ArturR0k3r/AkiraE/0. HW/Akira Basic/Screenshot 2024-01-05 033526.png

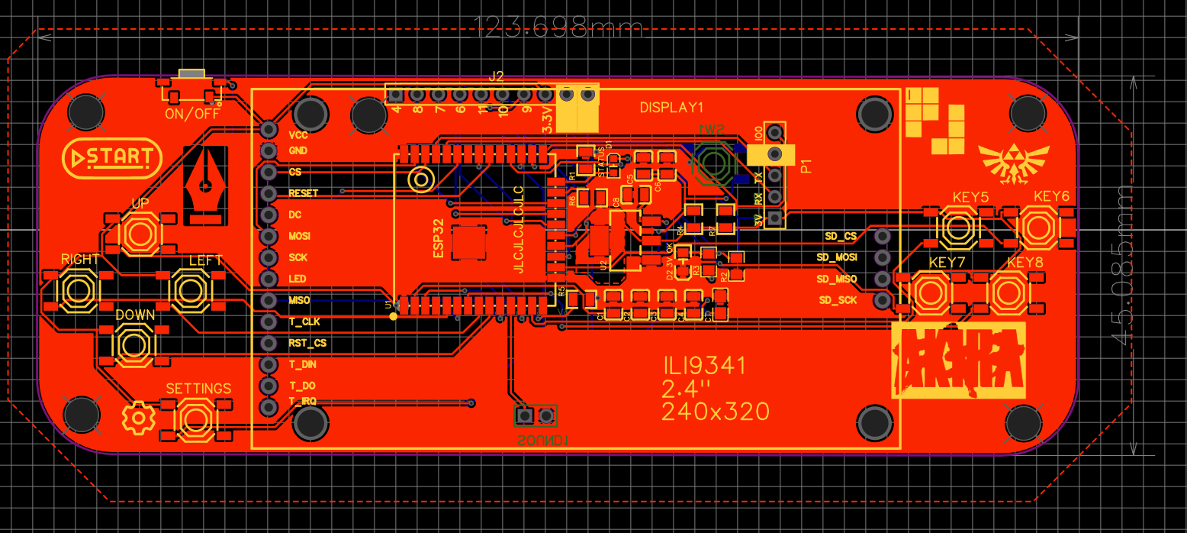
0. HW/Akira Basic/Screenshot 2024-01-05 033526.png
