ArturR0k3r/AkiraE/0. HW/Akira f1/Screenshot 2024-01-05 034120.png

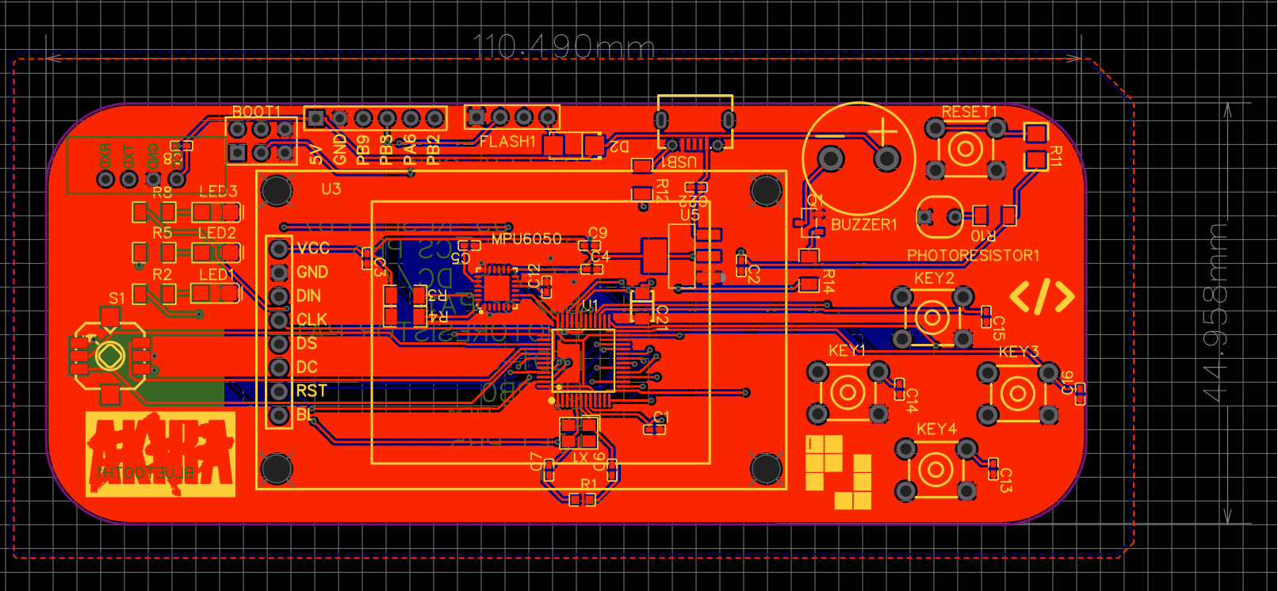
0. HW/Akira f1/Screenshot 2024-01-05 034120.png
