ArturR0k3r/AkiraE/0. HW/Akira Joystick/Screenshot 2024-01-05 034321.png

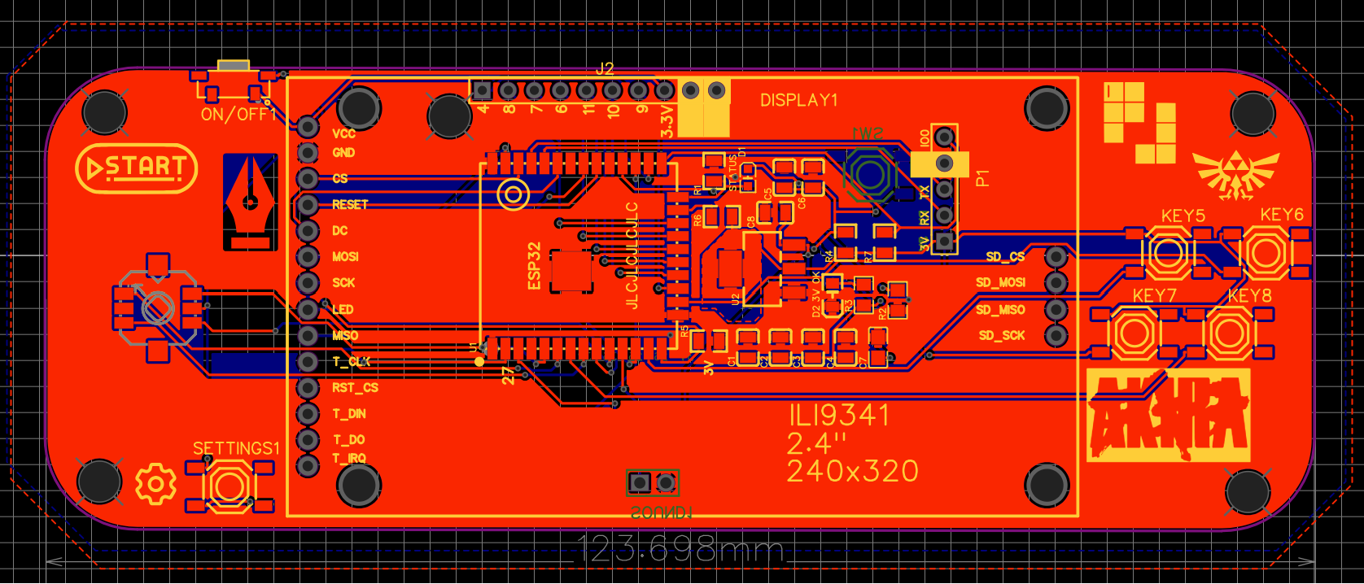
0. HW/Akira Joystick/Screenshot 2024-01-05 034321.png
