ArturR0k3r/AkiraE/2. Design and 3D Models/AkiraE-2024-01-15 162406.png

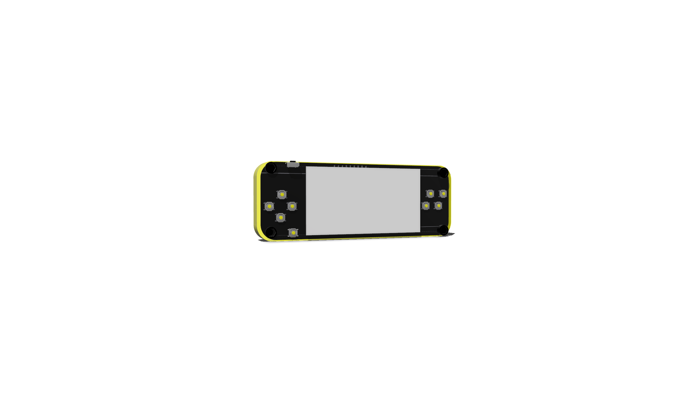
2. Design and 3D Models/AkiraE-2024-01-15 162406.png
