ArturR0k3r/AkiraE/2. Design and 3D Models/Drawings/image (8).png

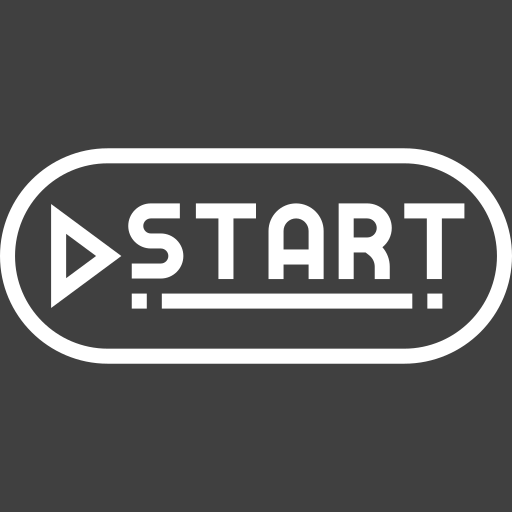
2. Design and 3D Models/Drawings/image (8).png
