ArturR0k3r/AkiraE/2. Design and 3D Models/Drawings/settings (1).png

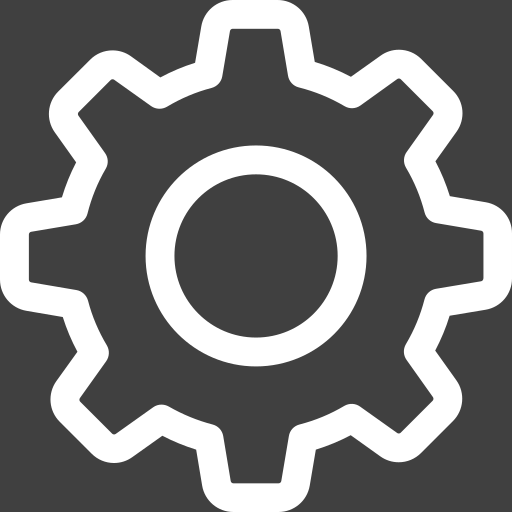
2. Design and 3D Models/Drawings/settings (1).png
