ArturR0k3r/AkiraE/2. Design and 3D Models/Drawings/video-game.png

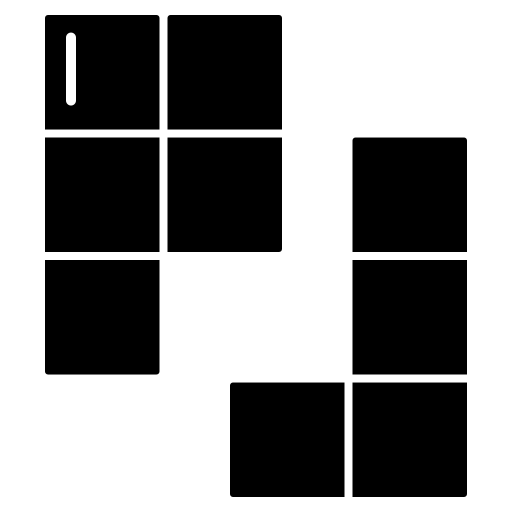
2. Design and 3D Models/Drawings/video-game.png
