ArturR0k3r/AkiraE/2. Design and 3D Models/Screenshot 2024-01-15 163319.png

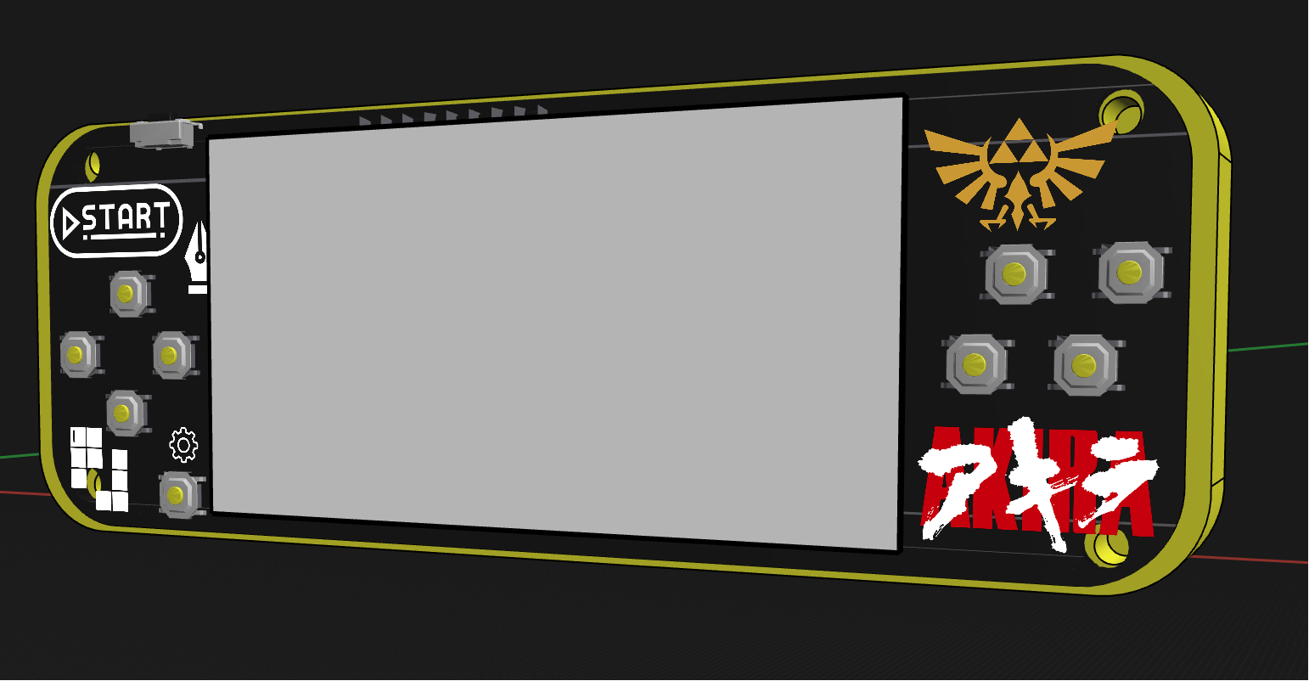
2. Design and 3D Models/Screenshot 2024-01-15 163319.png
