ArturR0k3r/AkiraE/2. Design and 3D Models/Screenshot_2024-01-15_163319-removebg-preview.png

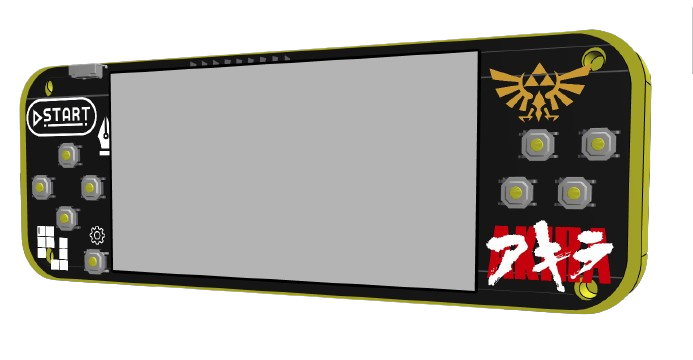
2. Design and 3D Models/Screenshot_2024-01-15_163319-removebg-preview.png
