ArturR0k3r/AkiraE/0. HW/Akira Basic/BOM_PCB_Akira_Basic_2024-01-05.csv

ID | Name | Designator | Footprint | Quantity | Manufacturer Part | Manufacturer | Supplier | Supplier Part | Price
1 | HDR-M-2.54_1x2 | SOUND1 | HDR-M-2.54_1X2 | 1 |  |  | LCSC | C124375 | 0.022
2 | RESET | SW1 | SW-SMD_4P-L5.1-W5.1-P3.70-LS6.5-TL-2 | 1 | TS-1187A-B-A-B | XKB Enterprise | LCSC | C318884 | 0.016
3 | HDR-M-2.54_1x10 | J2 | HDR-M-2.54_1X10 | 1 |  |  | LCSC | C57369 | 0.044
4 | 100nF | C4,C6,C8 | C0805 | 3 | CC0805KRX7R9BB104 | YAGEO | LCSC | C49678 | 0.005
5 | AMS1117-3.3 | U2 | SOT-223-3_L6.5-W3.4-P2.30-LS7.0-BR | 1 | AMS1117-3.3 | AMS | LCSC | C6186 | 0.141
6 | ESP32 | U1 | WIFIM-SMD_38P-L19.2-W18.0-P1.27 | 1 | ESP32 |  | LCSC | C328062 | 3.338
7 | 470Ω | R3,R2 | R0805 | 2 | 0805W8F4700T5E | UniOhm | LCSC | C17710 | 0.002
8 | 10K | R7,R6,R5,R4,R1 | R0805 | 5 | 0805W8F1002T5E | UniOhm | LCSC | C17414 | 0.001
9 | YELLOW | D2 | LED0805-RD | 1 | 17-21SUYC/TR8 | KENTO | LCSC | C2296 | 0.012
10 | 1uF | C5 | C0805 | 1 | CL21B105KBFNNNE | SAMSUNG | LCSC | C28323 | 0.009
11 | 10uF | C1,C2,C3,C7 | C0805 | 4 | CL21A106KAYNNNE | SAMSUNG | LCSC | C15850 | 0.011
12 | Header-Male-2.54_1x5 | P1 | HDR-5X1/2.54 | 1 | Header-Male-2.54_1x5 | LCSC
13 | STATUS (BLUE) | D1 | LED0603-R-RD | 1 | 19-217/BHC-ZL1M2RY/3T | EVERLIGHT | LCSC | C72041 | 0.018
14 | 2.4_TFT_ILI9341_symbol | DISPLAY1 | ILI9341_320X240_TFT_LCD | 1 |  |  | Nettigo | ili9341-24-touch
15 | BUTTON_C9900016052 | KEY5,KEY7,KEY8,KEY6,UP,SETTINGS,RIGHT,LEFT,DOWN | SW-SMD_4P-L5.1-W5.1-P3.70-LS6.5-TL-2 | 9 | button | null | LCSC | C9900016052
16 | TL3330AF260QG | ON/OFF | SW-SMD_E-SWITCH_TL3330 | 1 | TL3330AF260QG | E-Switch | LCSC | C2886886 | 0.358
