ArturR0k3r/AkiraE/0. HW/Akira f1/BOM_PCB_Akira_f1_2024-01-05.csv

ID | Name | Designator | Footprint | Quantity | Manufacturer Part | Manufacturer | Supplier | Supplier Part | Price
1 | HC06 | BLUETOOTH1 | HC06 | 1 |  |  | LCSC
2 | 10uF | C8 | C0402 | 1 | VT1H0R1MB054000CE0 | Changzhou Huawei Elec | LCSC | C271438 | 0.035
3 | 22uF | C9 | C0402 | 1 | VT1H0R1MB054000CE0 | Changzhou Huawei Elec | LCSC | C271438 | 0.035
4 | Photoresistor-5528 | PHOTORESISTOR1 | SNR2-3.0 | 1 | Photoresistor-5528
5 | Headers Pins 1*4P | FLASH1 | HDR-4X1/2.54 | 1 | Headers Pins 1*4P | ReliaPro | LCSC
6 | BUZZER | BUZZER1 | BUZ-TH_BD12.0-P6.00-D0.9-RD | 1 | buzzer | null | LCSC | C9900014030
7 | 100nF | C1,C2,C3,C4,C12,C13,C14,C15,C16,C21,C22 | C0402 | 11 | TAJA104K035RNJ | Kyocera AVX | LCSC | C7173 | 0.162
8 | XTAL4-3.2X2.5 8MHz | X1 | CRYSTAL-SMD_4P-L3.2-W2.5-BL | 1 | XTAL4-3.2X2.5 | null | LCSC | C9900003449
9 | USB-111FD-B-SU | USB1 | USB-SMD_USB-111FD-B-SU | 1 | USB-111FD-B-SU B型 | HOOYA(香港皓宇) | LCSC | C2939564 | 0.099
10 | LM1117MPX-25NOPB | U5 | SOT-223_L6.5-W3.5-P2.30-LS7.0-BR | 1 | LM1117MPX-25NOPB | onsemi(安森美) | LCSC | C2902257 | 0.584
11 | 1.8inch LCD TFT ST7735S Waveshare | U3 | 1.8 LCD TFT ST7735S WAVESHARE | 1
12 | STM32F103C8T6 | U1 | LQFP-48_L7.0-W7.0-P0.50-LS9.0-BL | 1 | STM32F103C8T6 | ST(意法半导体) | LCSC | C8734 | 1.421
13 | JOYSTICK_MINI | S1 | JOYSTICK_MINI | 1
14 | 10k | R11 | 1206 | 1 | ?
15 | 470Ω | R14 | R1206 | 1 | RTT06472JTP | RALEC(旺诠) | LCSC | C104821 | 0.003
16 | 4.7kΩ | R12,R3,R4 | R1206 | 3 | RTT06472JTP | RALEC(旺诠) | LCSC | C104821 | 0.003
17 | 100kΩ | R10 | R1206 | 1 | RTT06472JTP | RALEC(旺诠) | LCSC | C104821 | 0.003
18 | 220Ω | R8,R5,R2 | R1206 | 3 | RTT06472JTP | RALEC(旺诠) | LCSC | C104821 | 0.003
19 | 1M | R1 | R0603 | 1
20 | MMBT2222A_C466638 | Q1 | SOT-23-3_L2.9-W1.4-P1.90-LS2.6-BR | 1 | MMBT2222A | High Diode(海德) | LCSC | C466638 | 0.018
21 | 11-21/G6C-BQ2R2B/2T | LED3,LED2,LED1 | LED1206-RD | 3 | 11-21/G6C-BQ2R2B/2T | null | LCSC | C9900016674
22 | button6*6*8.5 | RESET1,KEY4,KEY3,KEY2,KEY1 | KEY-TH_4P-L6.0-W6.0-P4.50 | 5 | button6*6*8.5 | ReliaPro | LCSC | C59980 | 0.016
23 | HDR-M-2.54_1x6 | J1 | HDR-M-2.54_1X6 | 1 |  |  | LCSC | C190819 | 0.035
24 | 1N4007_C2892673 | D2 | SMA_L4.3-W2.6-LS5.1-R-RD | 1 | 1N4007 | YONGYUTAI(永裕泰) | LCSC | C2892673 | 0.006
25 | 27pF | C7,C6 | C0402 | 2
26 | 2.54mm2*3P | BOOT1 | HDR-3X2/2.54 | 1 | 2.54mm2*3P直排针袋装环保 | BOOMELE | LCSC | C65114 | 0.029
27 | 220nF | C5 | C0402 | 1 | TAJA224K035RNJ | Kyocera AVX | LCSC | C11364 | 0.141
28 | MPU6050-YJLTY | MPU6050 | QFN-24_L4.0-W4.0-P0.50-BL-EP2.7 | 1 | MPU6050-YJLTY | null | LCSC | C2912107
