ArturR0k3r/AkiraE/2. Design and 3D Models/3d Models/AkiraD/AkiraDBody.3mf

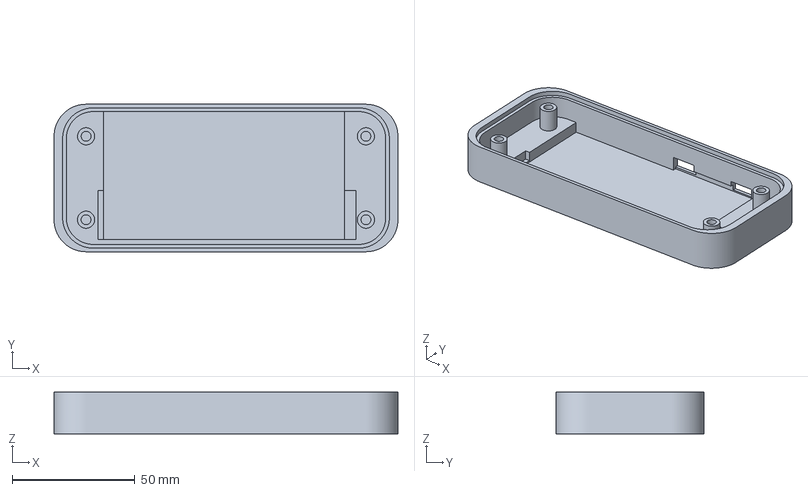
[picture p11: CAD file, 2024-01-17]
2. Design and 3D Models/3d Models/AkiraD/AkiraDBody.3mf
140.0 x 60.0 x 17.0 mm
