ArturR0k3r/AkiraE/2. Design and 3D Models/3d Models/rev1/AkiraE.step

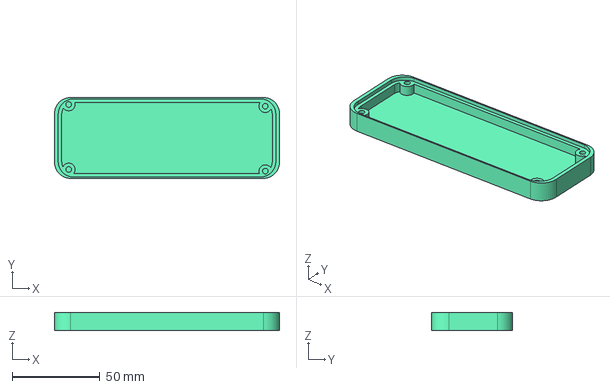
[picture p12: CAD file, 2024-01-05]
2. Design and 3D Models/3d Models/rev1/AkiraE.step
128.2 x 46.0 x 10.3 mm
