ArturR0k3r/AkiraE/2. Design and 3D Models/3d Models/AkiraD/AkiraDTop.3mf

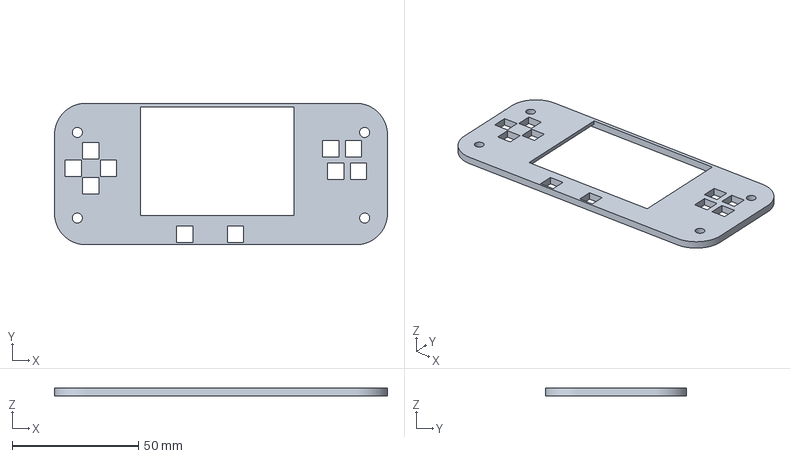
[picture p13: CAD file, 2024-01-17]
2. Design and 3D Models/3d Models/AkiraD/AkiraDTop.3mf
132.0 x 56.0 x 3.00 mm
