ArturR0k3r/AkiraE/2. Design and 3D Models/3d Models/AkiraD/small.3mf

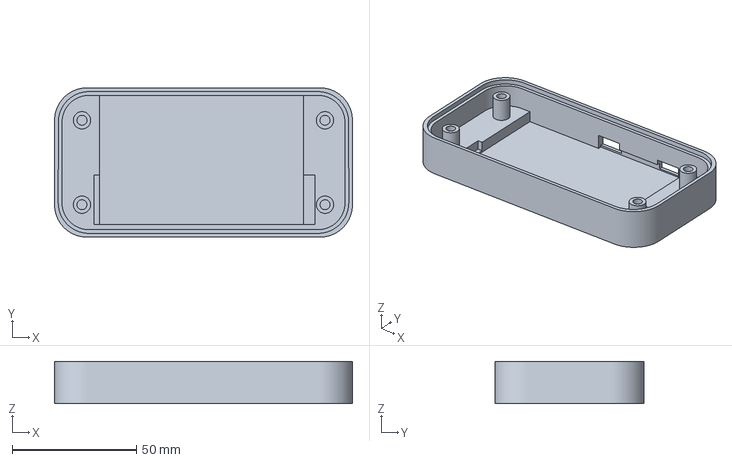
[picture p14: CAD file, 2024-01-17]
2. Design and 3D Models/3d Models/AkiraD/small.3mf
119.9 x 60.0 x 17.0 mm
