ArturR0k3r/AkiraE/(list of files, cad)

Other CAD files:
2. Design and 3D Models/Drawings/AkiraE-AkiraE Housing Drawing.dwg
2. Design and 3D Models/3d Models/AkiraD/Akira prototype.stl
2. Design and 3D Models/3d Models/rev1/AkiraE.3mf
2. Design and 3D Models/3d Models/rev1/AkiraE.obj
