ArturR0k3r/AkiraE/0. HW/Akira Joystick/Schematic_Akira Joystick_2024-01-05.pdf

IO0 25 IO4 26 IO16 27 IO17 28 IO5 29 IO18 30 IO19 31 NC 32 IO21 33 RXD0 34 TXD0 35 IO22 36 IO23 37 GND 38

MCU | Controls

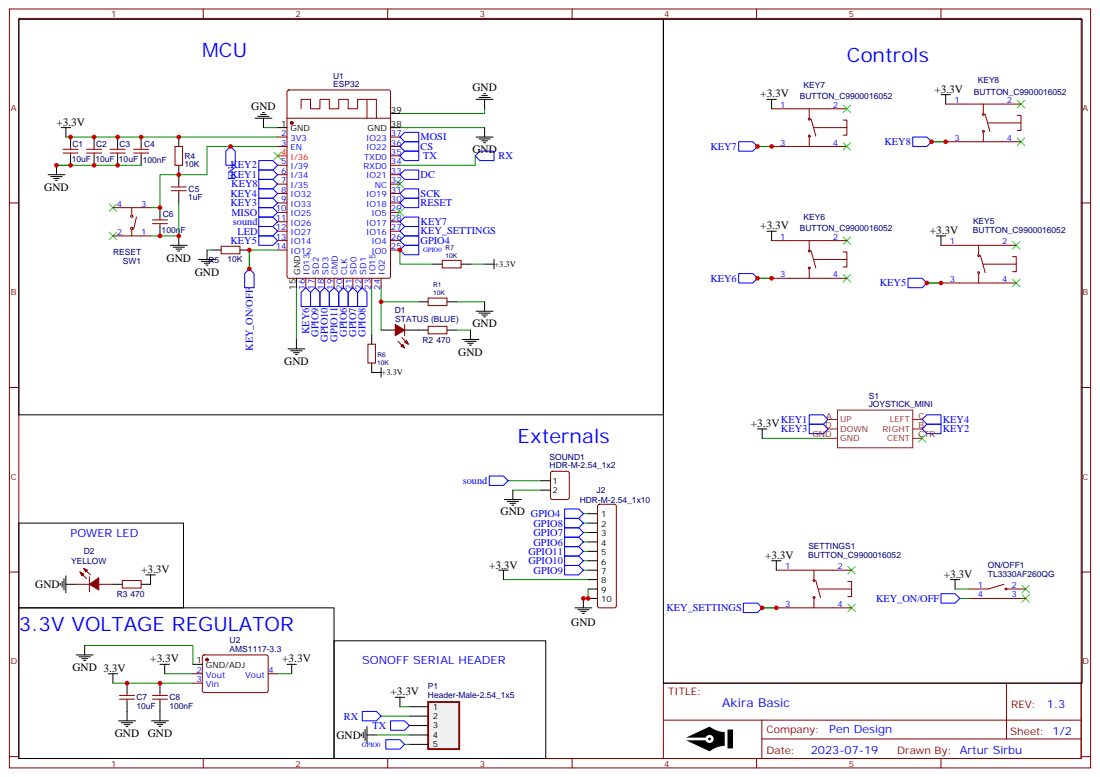
[picture p17: page 1]

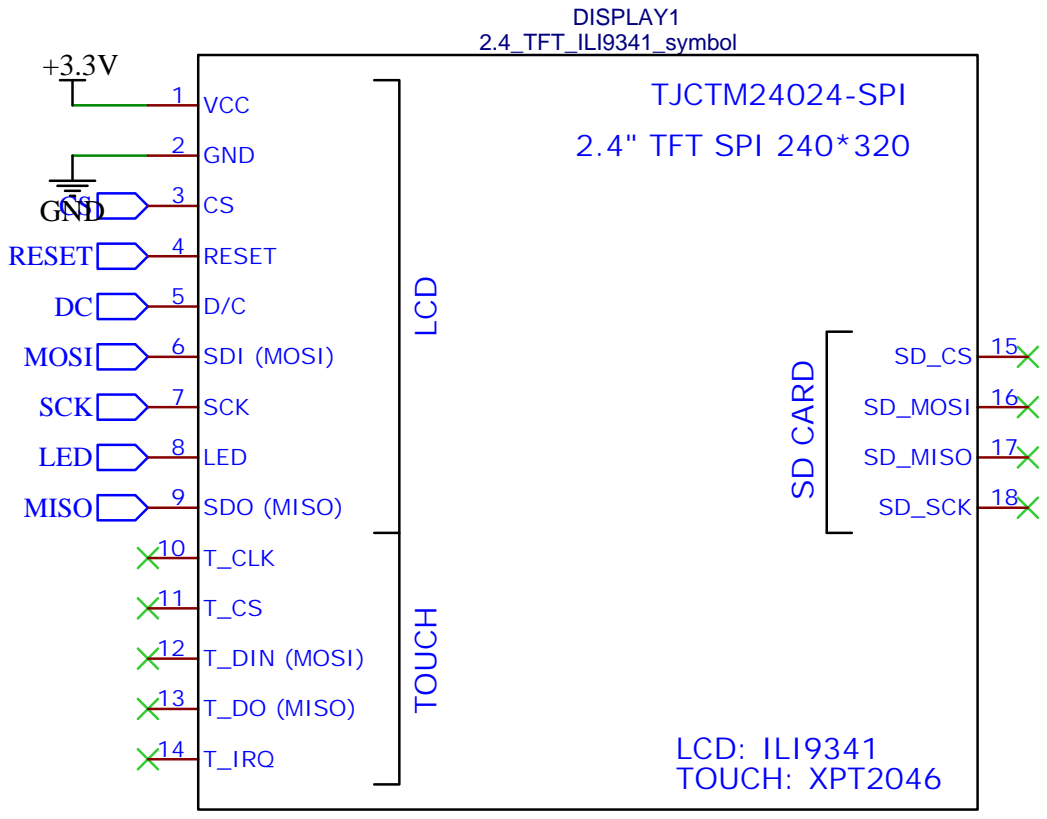
[picture p18: page 2]
