ArturR0k3r/AkiraE/3. Docs/5-Way_Tactile_Switch_BOB_mechanical_v10.pdf

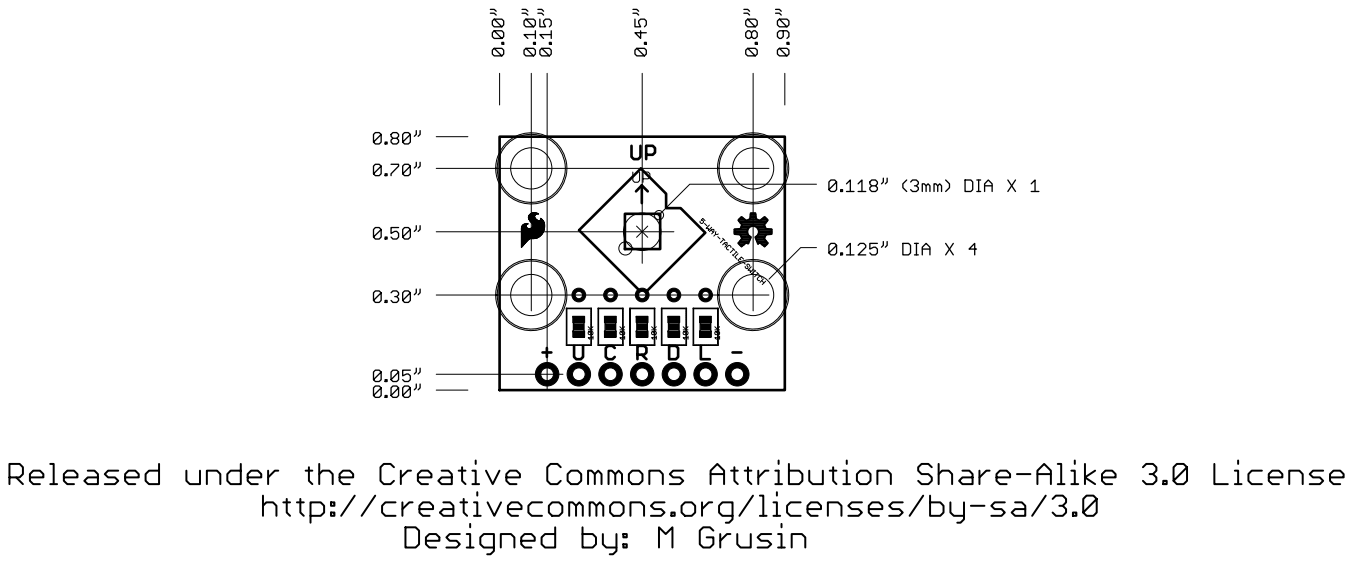
[picture p19: page 1]
