ArturR0k3r/AkiraE/0. HW/Akira f1/Schematic_Akira f1_2024-01-05.pdf

## Micro USB

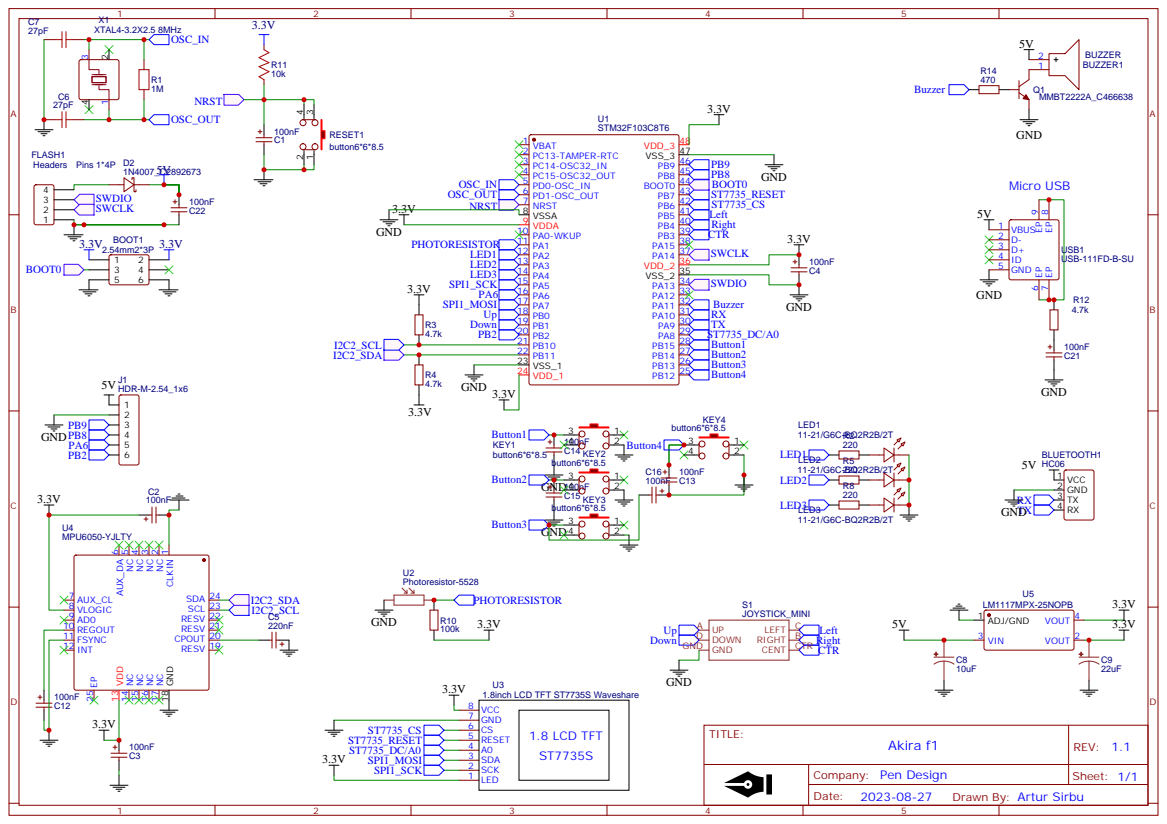
[picture p20: page 1]

Drawn By: Artur Sirbu
