ArturR0k3r/AkiraE/2. Design and 3D Models/Drawings/AkiraE-AkiraE Housing Drawing.pdf

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

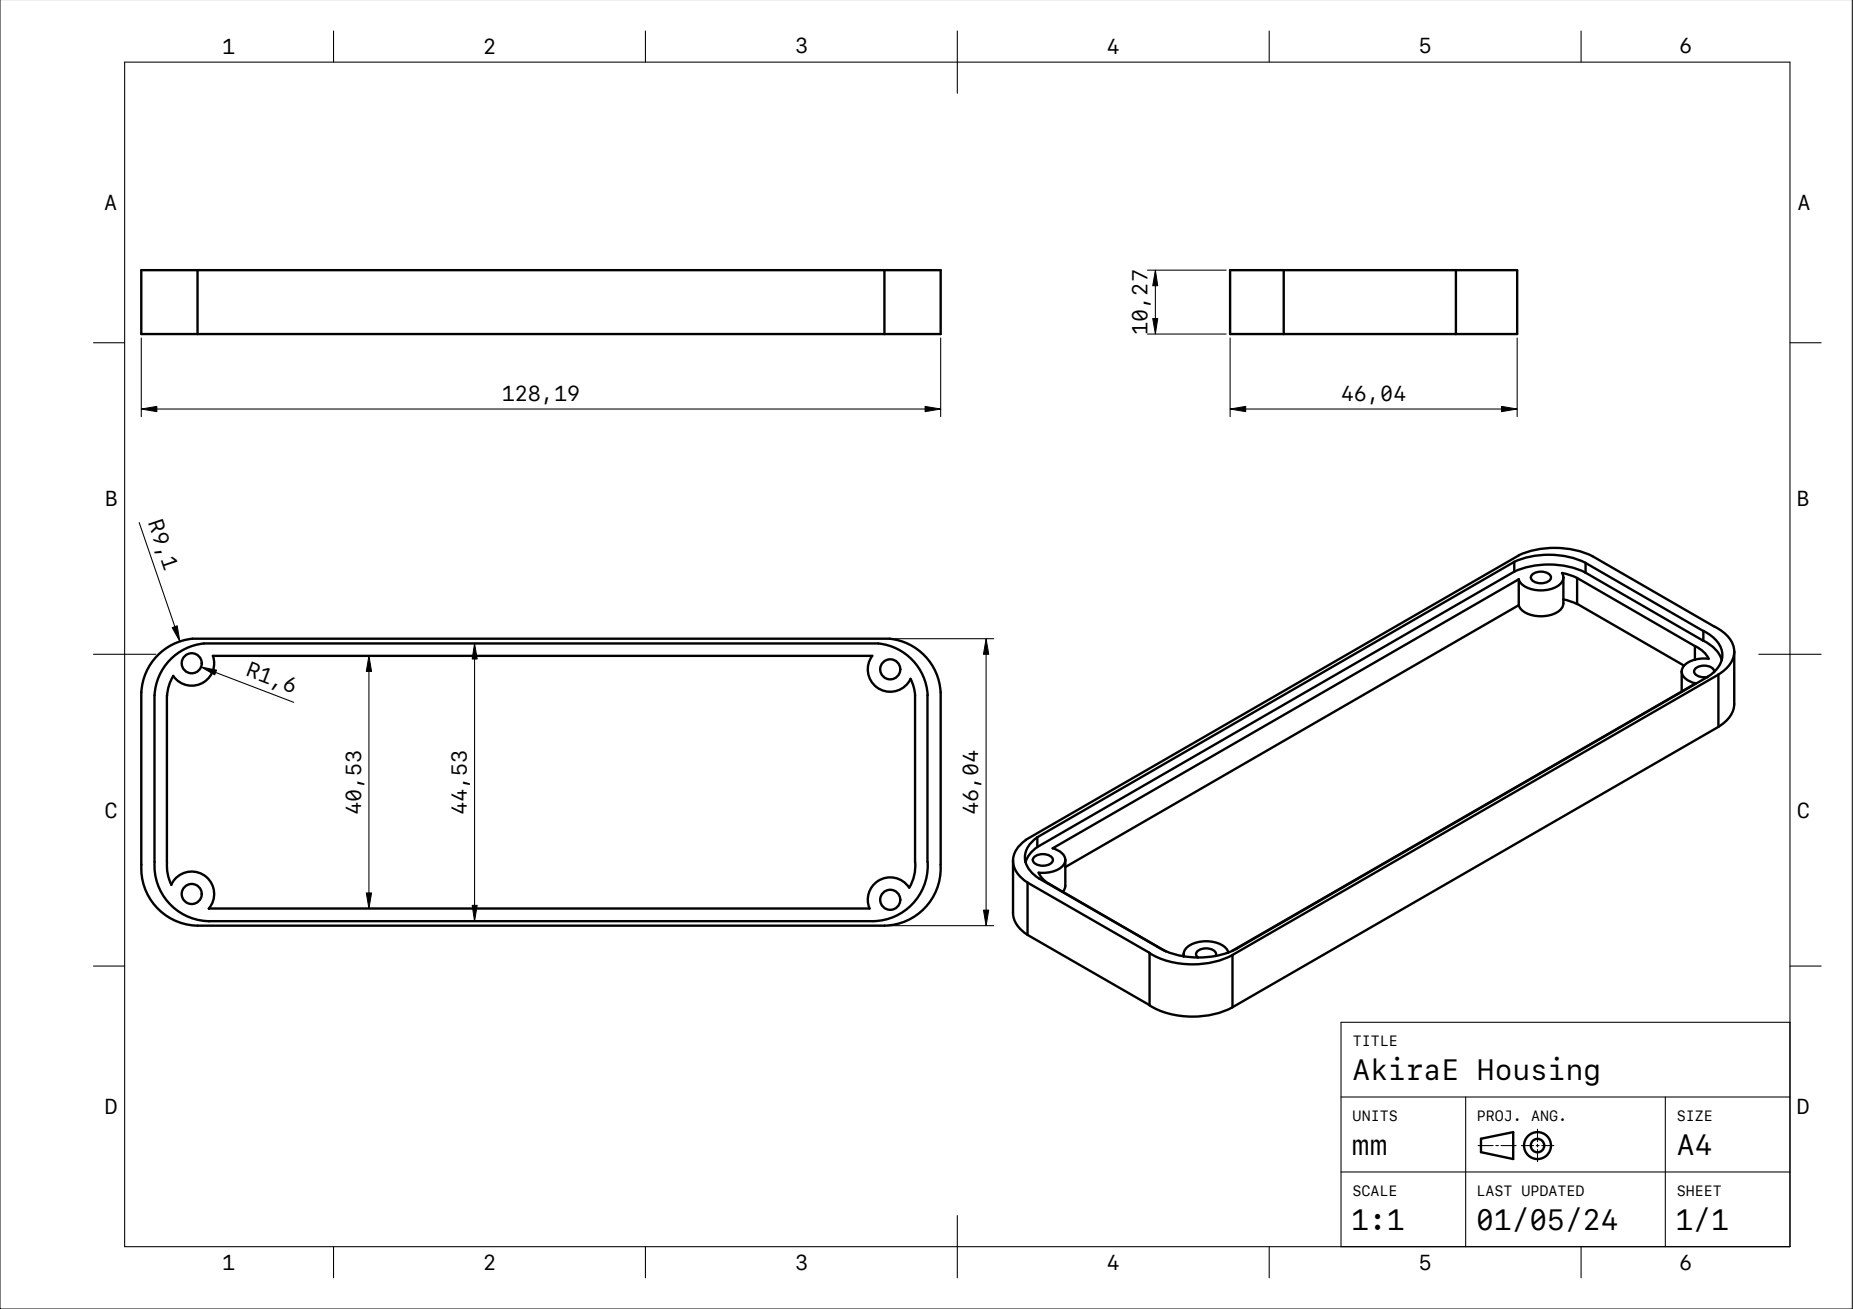
[picture p21: page 1]
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
