ArturR0k3r/AkiraE/3. Docs/5-Way_Tactile_Switch_BOB_v11.pdf

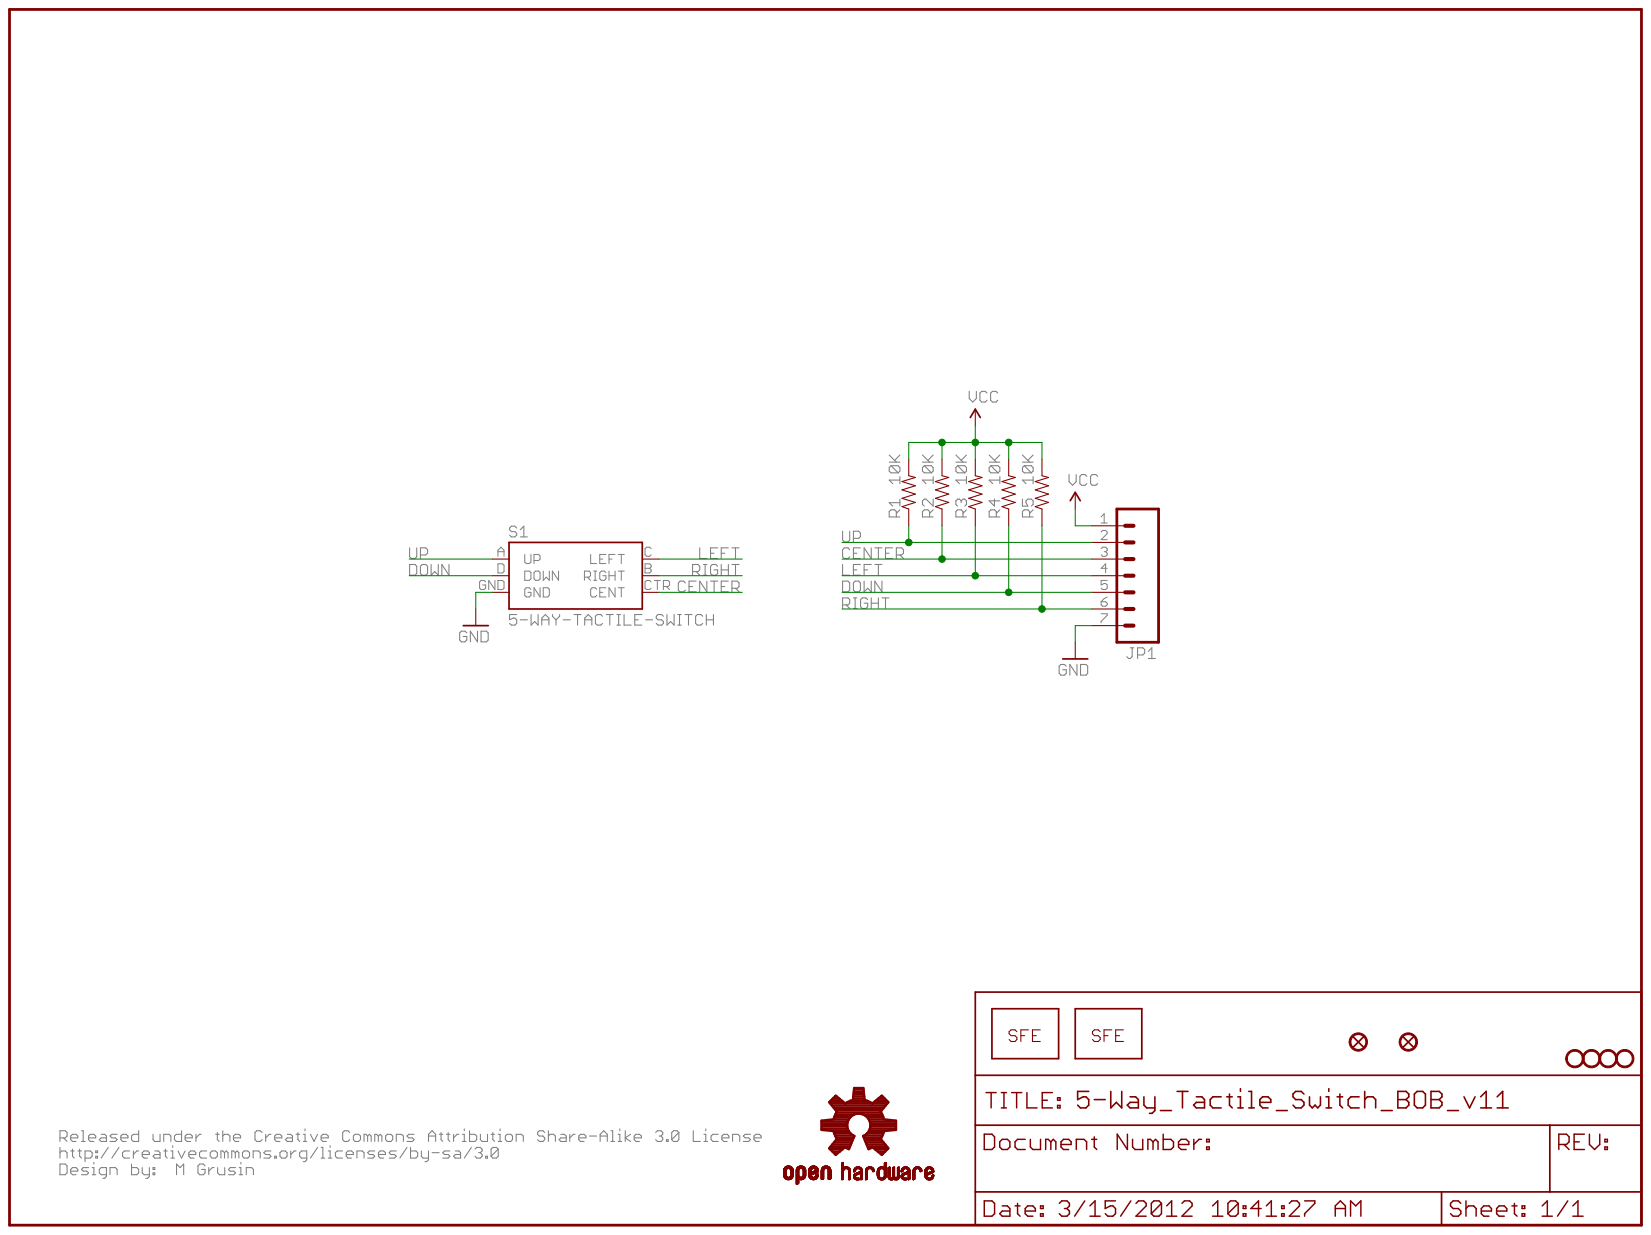
[picture p22: page 1]
