ArturR0k3r/AkiraE/(list of files, drawings)

Other design files:
0. HW/Akira Basic/PCB_Akira_Basic_2024-01-05.pcbdoc
0. HW/Akira Basic/PCB_PCB_Akira_Basic_2024-01-05.json
0. HW/Akira Basic/SCH_Akira Basic_2024-01-05.json
0. HW/Akira f1/PCB_Akira_f1_2024-01-05.pcbdoc
0. HW/Akira f1/PCB_PCB_Akira_f1_2024-01-05.json
0. HW/Akira f1/SCH_Akira f1_2024-01-05.json
0. HW/Akira f1/Sheet_1_2024-01-05.schdoc
0. HW/Akira Joystick/PCB_Akira_Joystick_2024-01-05.pcbdoc
0. HW/Akira Joystick/PCB_PCB_Akira_Joystick_2024-01-05.json
0. HW/Akira Joystick/SCH_Akira Joystick_2024-01-05.json
