ArturR0k3r/AkiraE/(commit log)

2024-01-05 Revision 1.3 update from local and old projects (Aurora 7.1 XorBoy OriGame became Akira)
    [AkiraE-AkiraE Housing Drawing.dwg, AkiraE.3mf, AkiraE.obj, AkiraE.step, BOM_PCB_Akira_Basic_2024-01-05.csv, BOM_PCB_Akira_Joystick_2024-01-05.csv, BOM_PCB_Akira_f1_2024-01-05.csv, PCB_Akira_Basic_2024-01-05.pcbdoc]
2024-01-09 NofrendoAkira 0
    [AkiraDBody.3mf, AkiraDTop.3mf, AkiraE.3mf, AkiraE.obj, AkiraE.step, partitions.csv]
2024-01-17 AkiraNofrendoNes Build Issues half fixed
    [Akira prototype.stl, AkiraDBody.3mf, AkiraDTop.3mf, partitions.csv, small.3mf]
2024-01-17 build issues fix 2
    [video_audio.c]
